Vip3Outs/Digital_lock_with_fingerprint_sensor/(commit log)

2020-12-14 14.12.2020 16:00
    poprawki na I2C.c i .h
    funkcja deleteFinger() w main.c
2020-12-29 Beta v1.1
    Wersja testowana, działająca bez widocznych bugów
    [lcd.c, lcd.h, main.c]
